tamsle/Diplomaterv/LPC.PNG

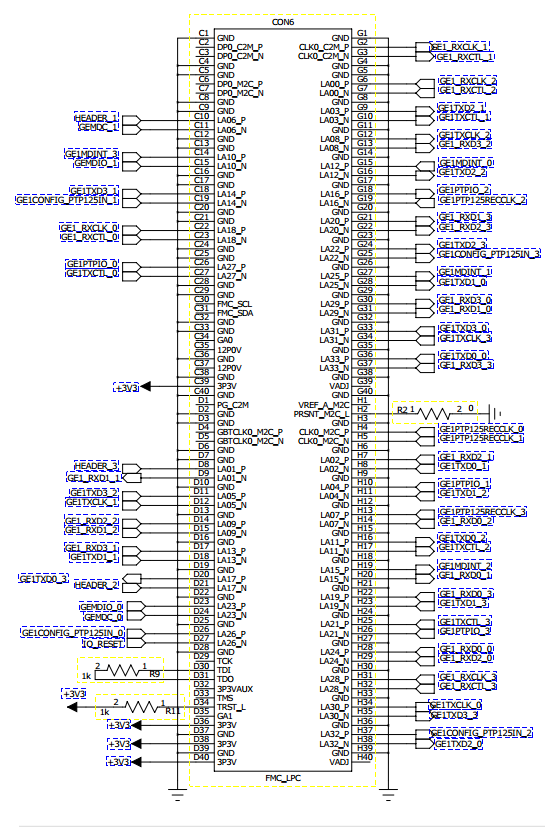
LPC.PNG
