tamsle/Diplomaterv/NYAK.PNG

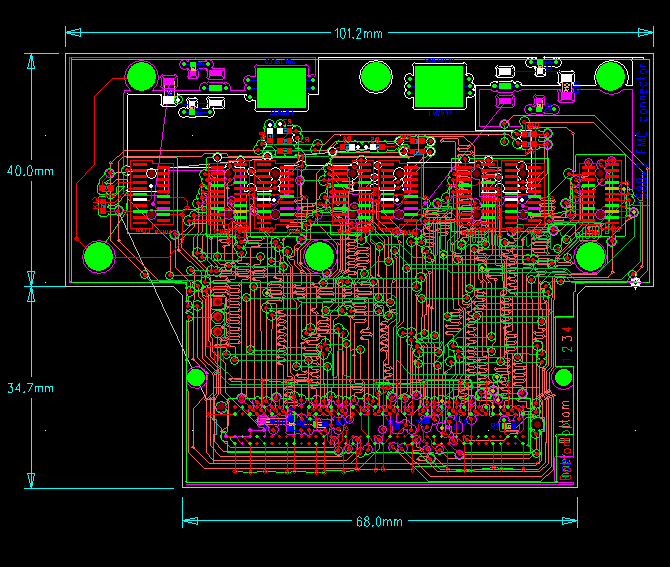
NYAK.PNG
