tamsle/Diplomaterv/BOM.xlsx

 | darab
 | 1 | J63 | ASP_134604_01 | ASP_134604_01 | ASP_134604_01 |  |  | SAMTEC | ASP_134604_01 | http://octopart.com/asp-134604-01-samtec-19095067
 |  |  |  |  |  |  |  |  |  | http://www.newark.com/samtec/asp-134604-01/conn-vita-57-fmc-header-160pos/dp/79X1317?CMP=AFC-OP
ASP-134604-01 | MC-LPC-10 | male | 10 mm | Lead-Free | Low | PDF Print (http://www.samtec.com/Prints/ASP-134604-01-mkt.pdf) | PADS |  |  | http://datasheet.octopart.com/ASP-134604-01-Samtec-datasheet-27844201.pdf
 | https://www.samtec.com/my-samtec/order.aspx |  |  |  |  |  |  |  |  | http://www.samtec.com/standards/vita.aspx
 |  |  |  |  |  |  |  |  |  | http://www.mirifica.it/store/lang-en/connettori/120-samtec-asp-134604-01.html
 |  |  |  |  |  |  |  |  |  | http://avnetexpress.avnet.com/store/em/EMController?term=asp-134604-01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
 | 8 |  | BKS-121-01-L-V-A-P |  | MMXP,MM1P |  |  |  |  | https://www.samtec.com/technical-specifications/default.aspx?SeriesMaster=BKS
 | 2 |  | LM2937 |  | VOLTREG
 |  |  | http://hu.farnell.com/texas-instruments/lm2937imp-2-5/ic-v-reg-ldo-0-4a-2-5v-smd-2937/dp/9779299
 | 4 |  | GRM188R60G226MEA0L |  | CAP0603 22uF
 |  |  | http://uk.farnell.com/murata/grm188r60g226mea0l/cap-mlcc-x5r-22uf-4v-0603/dp/1845732RL
 | 1 |  | header 3x1
 | 11 |  | MC0603SAF0000T5E |  | RES 0 Ohm
 |  |  | http://hu.farnell.com/multicomp/mc0603saf0000t5e/resistor-thick-film-0r-0-1w-1/dp/2309111
 | 7 |  | RC0603JR-071KL |  | RES 1kOhm
 |  |  | http://hu.farnell.com/yageo/rc0603jr-071kl/resistor-thick-film-1kohm-100mw/dp/2309108
