tamsle/Diplomaterv/dipterv_voltreg_fpga_fin.pdf

D

6 | 5 | 4 | 3 | 2 | 1

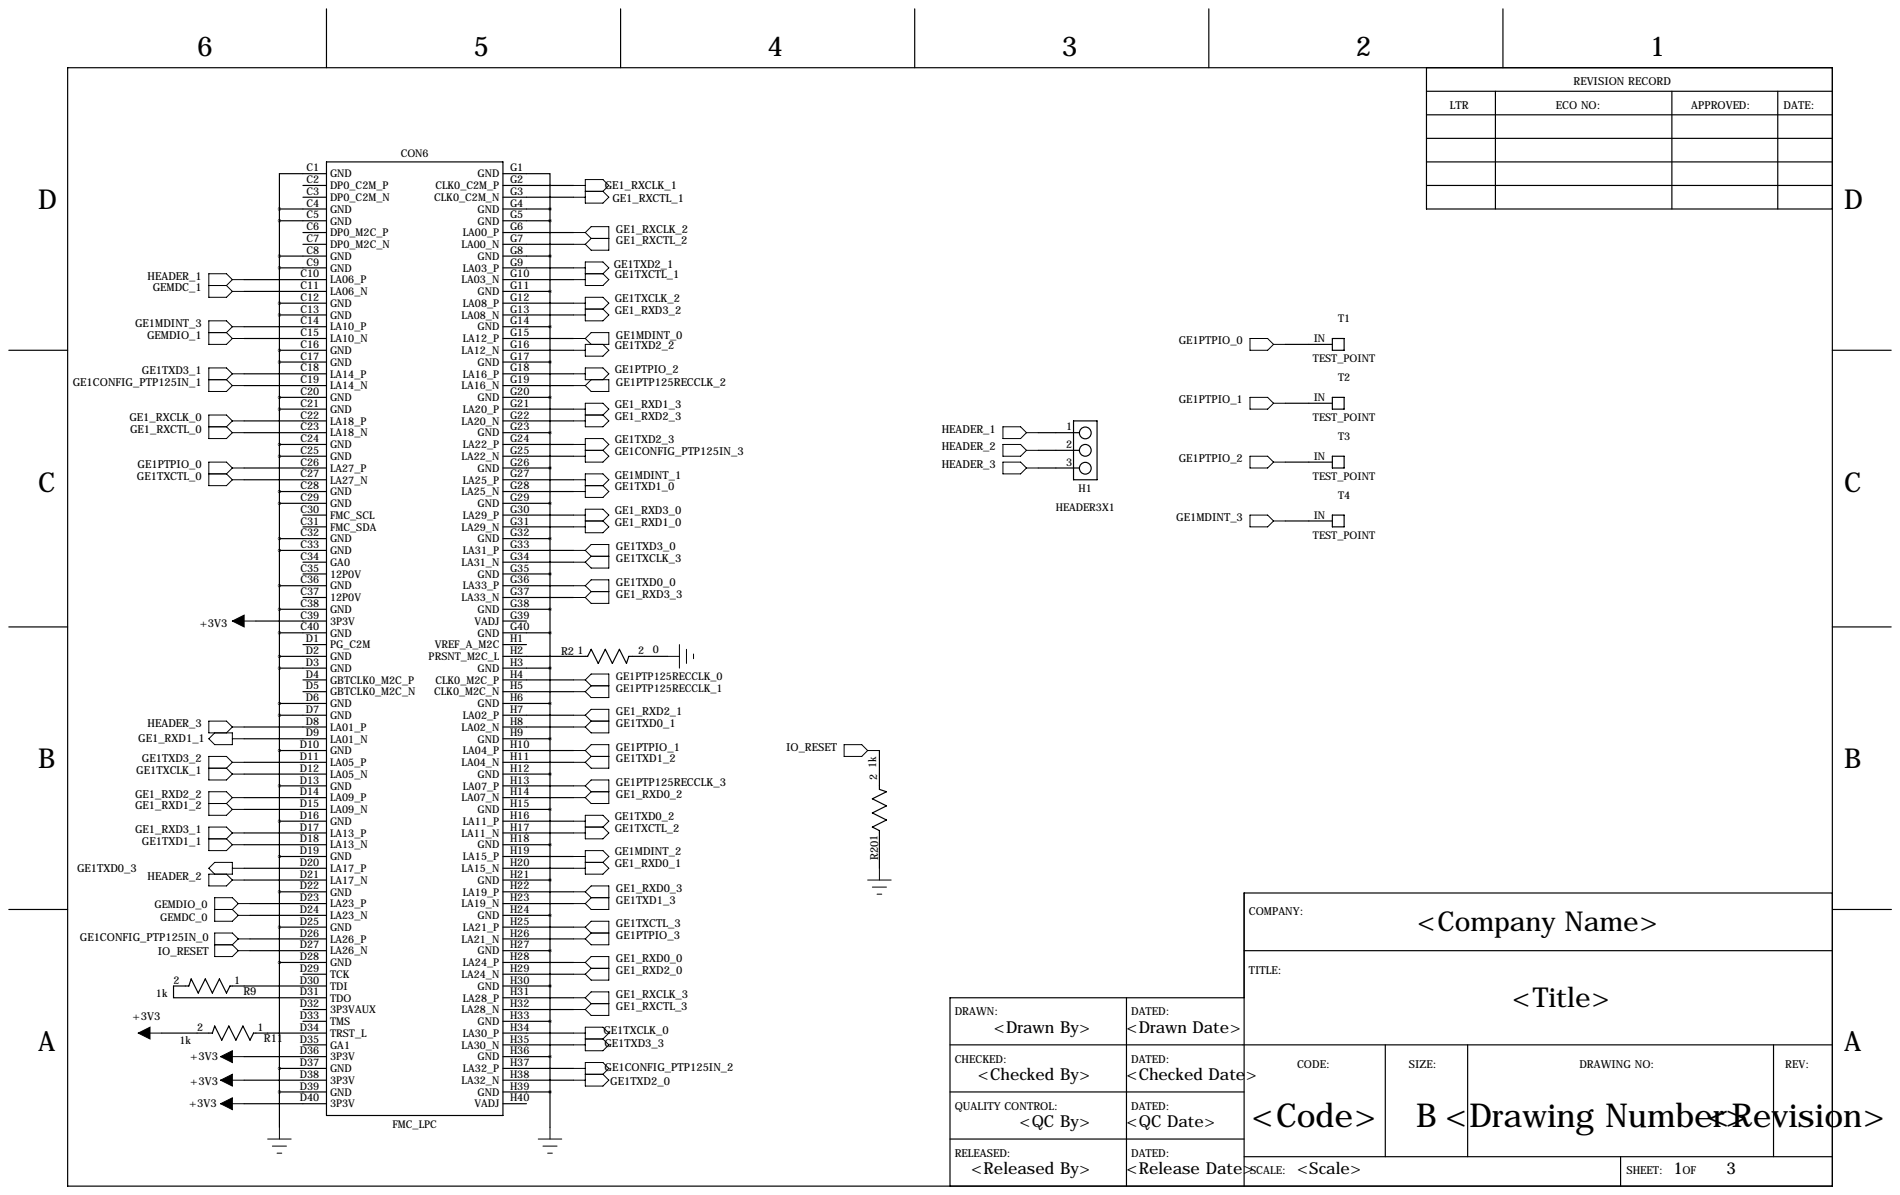
[picture p19: page 1]

CON6 | REVISION RECORD

LTR | ECO NO: | APPROVED: | DATE:

DRAWN: <Drawn By> | DATED: <Drawn Date>

CHECKED: <Checked By> | DATED: <Checked Date> | CODE: | SIZE: | DRAWING NO: | REV:

QUALITY CONTROL: <QC By> | DATED: <QC Date>

RELEASED: <Released By> | DATED:

<Scale> SCALE: | 1 3 SHEET: OF

D

D

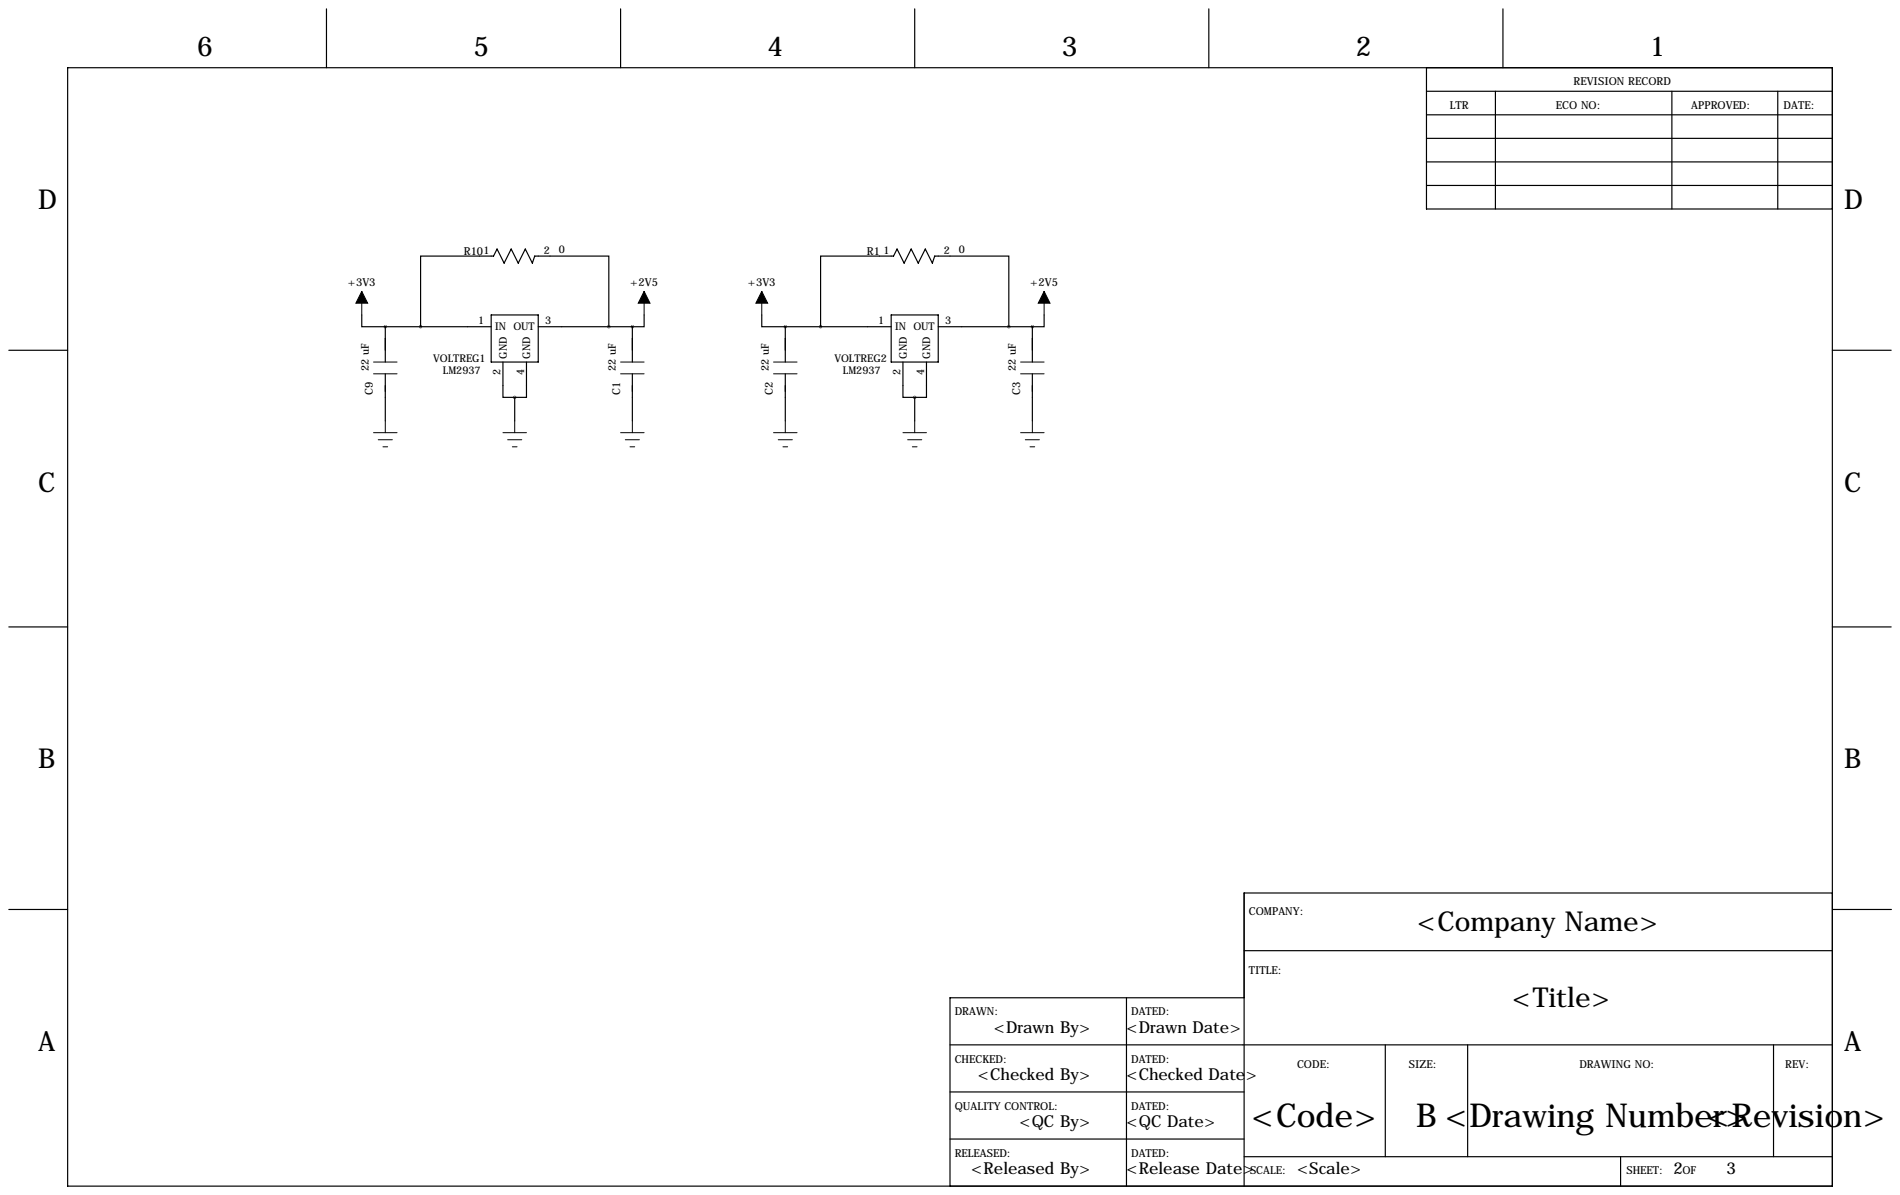
[picture p20: page 2]
<Company Name>; <Title>; <Code>; B <Drawing Number><Revision>; <Scale>; COMPANY:; TITLE:; OUT; 2 GND; VOLTREG1; GND; VOLTREG2

R101 2 0 R1 1 2 0 | REVISION RECORD

LTR | ECO NO: | APPROVED: | DATE:

DRAWN: <Drawn By> | DATED: <Drawn Date>

CHECKED: <Checked By> | DATED: <Checked Date> | CODE: | SIZE: | DRAWING NO: | REV:

QUALITY CONTROL: <QC By> | DATED: <QC Date>

D

D

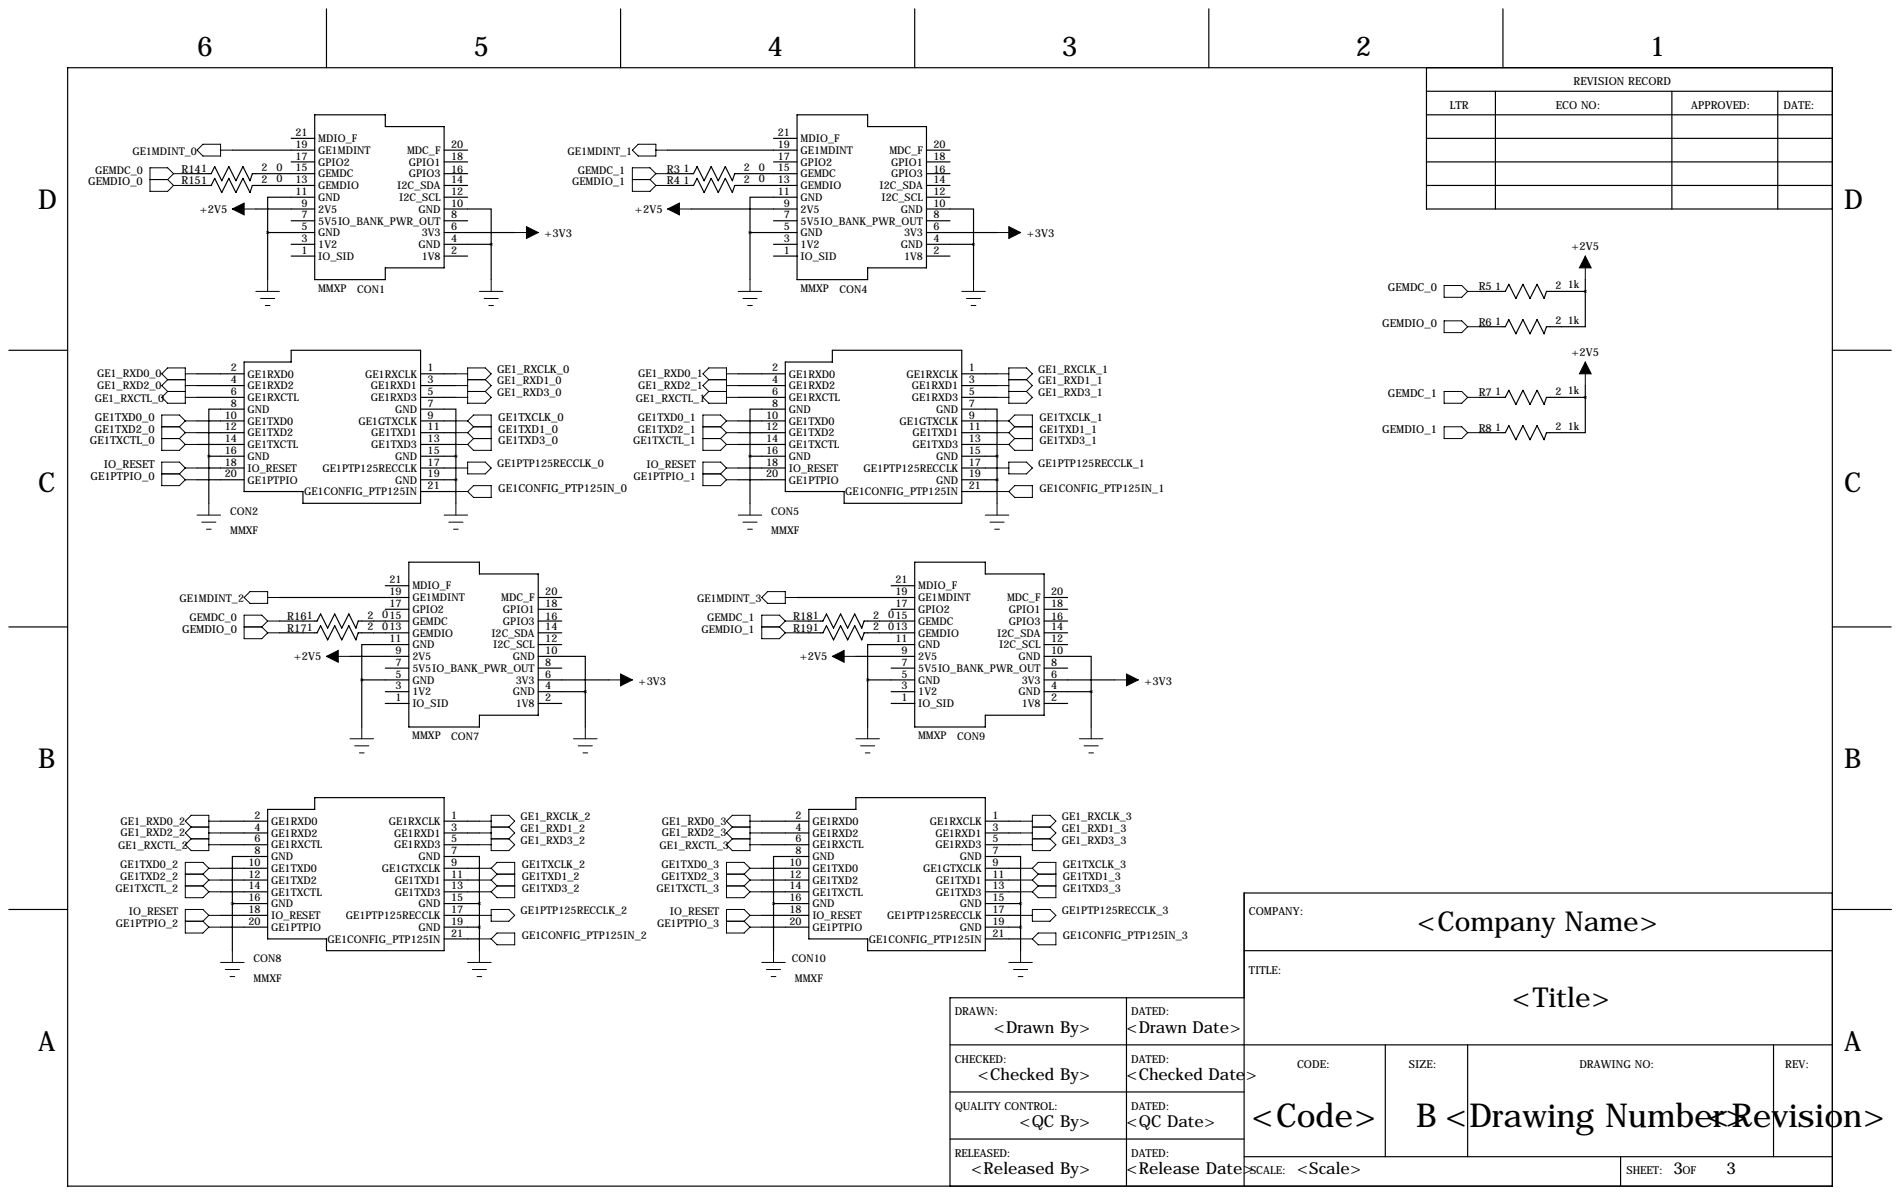
[picture p21: page 3]

REVISION RECORD

LTR | ECO NO: | APPROVED: | DATE:

DRAWN: <Drawn By> | DATED: <Drawn Date>

CHECKED: <Checked By> | DATED: <Checked Date> | CODE: | SIZE: | DRAWING NO: | REV:

QUALITY CONTROL: <QC By> | DATED: <QC Date>
