tamsle/Diplomaterv/(list of files, drawings)

Other design files:
CAM3/dipterv_20141103_done.pcb
