tamsle/Diplomaterv/(commit log)

2014-11-05 Gerber files added
    [dipterv_20141103_done.pcb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]
2014-11-16 Dokumentáció írás
    [BOM.xlsx, dipterv_20141103_done.pcb, dipterv_voltreg_fpga_fin.sch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]
